OpenTurn/OpenTurn_PSoC/README.md

# OpenTurn_PSoC

OpenTurn is a closed loop servo controller for BLDCs developed for robotics application.

## Key Specificiations
| Parameter | Value |
|---|---|
|Peak Current||
|Constant Current||
|Control Frequency|20kHz|
|Supply Voltage|24V - 48V|
|Encoder Resolution|14bit|
|Communications|CAN, U(S)ART|
|Control Modes| Torque, Speed, Position|

## Hardware
### PCB
For further information check the [PCB Design Doc](http://github.com)
### Auxilary

## Software
### How to build
The firmware is developed in Modus Toolbox by Cypress. Follow this guide to build the firmware from source in Modus toolbox, or flash a [precompiled hex image](http://github.com)
