OpenTurn/OpenTurn_PSoC/software/src/OpenTurn_project/README.md

# PSoC&trade; 6 MCU: dual-CPU empty application template

This is a minimal starter dual-CPU application template for PSoC&trade; 6 MCU devices.

[View this README on GitHub.](https://github.com/Infineon/mtb-example-psoc6-dual-cpu-empty-app)

[Provide feedback on this code example.](https://cypress.co1.qualtrics.com/jfe/form/SV_1NTns53sK2yiljn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)

## Requirements

- [ModusToolbox&trade; software](https://www.cypress.com/products/modustoolbox-software-environment) v2.2 or later (tested with v2.3)
- Board support package (BSP) minimum required version: 2.0.0
- Programming language: C
- Associated parts: All [PSoC&trade; 6 MCU](https://www.cypress.com/PSoC6) parts

## Supported toolchains (make variable 'TOOLCHAIN')

- GNU Arm® embedded compiler v9.3.1 (`GCC_ARM`) - Default value of `TOOLCHAIN`
- Arm&reg; compiler v6.13 (`ARM`)
- IAR C/C++ compiler v8.42.2 (`IAR`)

## Supported kits (make variable 'TARGET')

- [PSoC&trade; 6 Wi-Fi Bluetooth® prototyping kit](https://www.cypress.com/CY8CPROTO-062-4343W) (`CY8CPROTO-062-4343W`) - Default value of `TARGET`
- [PSoC&trade; 6 Wi-Fi Bluetooth&reg; pioneer kit](https://www.cypress.com/CY8CKIT-062-WiFi-BT) (`CY8CKIT-062-WIFI-BT`)
- [PSoC&trade; 6 Bluetooth&reg; LE pioneer kit](https://www.cypress.com/CY8CKIT-062-BLE) (`CY8CKIT-062-BLE`)
- [PSoC&trade; 6 Bluetooth&reg; LE prototyping kit](https://www.cypress.com/CY8CPROTO-063-BLE) (`CY8CPROTO-063-BLE`)
- [PSoC&trade; 62S2 Wi-Fi Bluetooth&reg; pioneer kit](https://www.cypress.com/CY8CKIT-062S2-43012) (`CY8CKIT-062S2-43012`)
- [PSoC&trade; 62S1 Wi-Fi Bluetooth&reg; pioneer kit](https://www.cypress.com/CYW9P62S1-43438EVB-01) (`CYW9P62S1-43438EVB-01`)
- [PSoC&trade; 62S1 Wi-Fi Bluetooth&reg; pioneer kit](https://www.cypress.com/CYW9P62S1-43012EVB-01) (`CYW9P62S1-43012EVB-01`)
- [PSoC&trade; 62S3 Wi-Fi Bluetooth&reg; prototyping kit](https://www.cypress.com/CY8CPROTO-062S3-4343W) (`CY8CPROTO-062S3-4343W`)
- [PSoC&trade; 62S4 pioneer kit](https://www.cypress.com/CY8CKIT-062S4) (`CY8CKIT-062S4`)
- Rapid IoT connect developer kit (`CYSBSYSKIT-DEV-01`)

## Design and implementation

This template has two applications - *cm0p_app* and *cm4_app*. Their makefiles were modified to establish a dependency between the two applications, so both images built are merged into one.

In the *cm0p_app* makefile, the following line were added to specify the application CPU:

```
CORE=CM0P
```

If you intend to use the *design.modus* generated code in CM0+, add `BSP_DESIGN_MODUS` to the `COMPONENTS=` in the CM0+ Makefile.

In the *cm4_app* Makefile, the following lines were added/modified to add a dependency to *cm0p_app*:

```
DISABLE_COMPONENTS=CM0P_SLEEP
DEPENDENT_APP_PATHS=../cm0p_app

getlibs : getlibs_cm0p
getlibs_cm0p:
	$(MAKE) -C ../cm0p_app/ $(MAKECMDGOALS)
```

The last lines are added to trigger the `make getlibs` command in the *cm0p_app* folder, when issuing the same command in the *cm4_app* folder. Each application should have its own *deps* folder. If the same library is used by both applications, it should be in the *deps* folder of both applications. If the library location is specified as the shared asset repo in the *mtb* file (which is by default), they will both automatically access it from the shared location.

When the CM4 project is built, it builds both the CM0+ and CM4 applications and the resulting build artifacts contain code for both applications. When the CM0+ application is built, it will only build that application. When the application starts, the CM0+ starts first. It is responsible for starting the CM4.

By default, *cm0p_app* uses only 8192 bytes of SRAM and flash. If you wish to allocate more memory to *cm0p_app*, follow the instructions from the "Customizing linker scripts" section in [AN215656](https://www.cypress.com/AN215656) – *PSoC&trade; 6 MCU dual-CPU system design*.

The HAL library supports only the CM4 CPU, so *cyhal.h* is not included in the CM0+ application. The PDL supports both the CM4 and CM0+.

## Related resources

| Application notes | |
| :--- | :--- |
| [AN228571](https://www.cypress.com/AN228571) – Getting started with PSoC&trade; 6 MCU on ModusToolbox&trade; software | Describes PSoC&trade; 6 MCU devices and how to build your first application with ModusToolbox&trade; software |
| [AN215656](https://www.cypress.com/AN215656) – PSoC&trade; 6 MCU: dual-CPU system design | Describes the dual-CPU architecture in PSoC&trade; 6 MCU, and shows how to build a simple dual-CPU design |
| **Code examples** | |
| PSoC&trade; 6 MCU examples | [mtb-example-psoc6-*](https://github.com/cypresssemiconductorco?q=mtb-example-psoc6%20NOT%20Deprecated) on GitHub  |
| **Device documentation** | |
| [PSoC&trade; 6 MCU datasheets](https://www.cypress.com/search/all?f[0]=meta_type%3Atechnical_documents&f[1]=resource_meta_type%3A575&f[2]=field_related_products%3A114026) | [PSoC&trade; 6 technical reference manuals](https://www.cypress.com/search/all/PSoC%206%20Technical%20Reference%20Manual?f[0]=meta_type%3Atechnical_documents&f[1]=resource_meta_type%3A583) |
| **Development kits** |Visit www.cypress.com/microcontrollers-mcus-kits and use the options in the **Select your kit** section to filter kits by *Product family* or *Features*. |
| **Libraries** | |
| PSoC&trade; 6 peripheral driver library (PDL) and docs  | [mtb-pdl-cat1](https://github.com/cypresssemiconductorco/mtb-pdl-cat1) on GitHub |
| Hardware abstraction layer (HAL) Library and docs | [mtb-hal-cat1](https://github.com/cypresssemiconductorco/mtb-hal-cat1) on GitHub |
| Retarget-IO - A utility library to retarget the standard input/output (STDIO) messages to a UART port | [retarget-io](https://github.com/cypresssemiconductorco/retarget-io) on GitHub |
| **Middleware** | |
| CAPSENSE&trade; library and documents | [capsense](https://github.com/cypresssemiconductorco/capsense) on GitHub |
| Links to all PSoC&trade; 6 MCU middleware | [psoc6-middleware](https://github.com/cypresssemiconductorco/psoc6-middleware) on GitHub |
| **Tools** | |
| [Eclipse IDE for ModusToolbox&trade; software](https://www.cypress.com/modustoolbox) | ModusToolbox&trade; software is a collection of easy-to-use software and tools enabling rapid development with Infineon MCUs, covering applications from embedded sense and control to wireless and cloud-connected systems using AIROC&trade; Wi-Fi and Bluetooth® connectivity devices. |

## Other resources

Cypress provides a wealth of data at www.cypress.com to help you select the right device, and quickly and effectively integrate it into your design.

For PSoC&trade; 6 MCU devices, see [How to design with PSoC&trade; 6 MCU - KBA223067](https://community.cypress.com/docs/DOC-14644) in the Cypress community.

## Document history

Document title: *CE230479* - *PSoC&trade; 6 MCU: dual-CPU empty application template*

| Revision | Description of change |
| ---  | --- |
| 1.0.0 | New code example |
| 2.0.0 | Major update to support ModusToolbox&trade; software v2.2. <br>This version is not backward compatible with ModusToolbox&trade; software v2.1 |
| 2.1.0 | Added support for CYSBSYSKIT-DEV-01 rapid IoT connect developer kit |
| 2.2.0 | Updated to support ModusToolbox&trade; software v2.3.<br /> Added support for CY8CKIT-062S4. |
------

All other trademarks or registered trademarks referenced herein are the property of their respective owners.

banner

-------------------------------------------------------------------------------

© Cypress Semiconductor Corporation, 2019-2021. This document is the property of Cypress Semiconductor Corporation, an Infineon Technologies company, and its affiliates ("Cypress").  This document, including any software or firmware included or referenced in this document ("Software"), is owned by Cypress under the intellectual property laws and treaties of the United States and other countries worldwide.  Cypress reserves all rights under such laws and treaties and does not, except as specifically stated in this paragraph, grant any license under its patents, copyrights, trademarks, or other intellectual property rights.  If the Software is not accompanied by a license agreement and you do not otherwise have a written agreement with Cypress governing the use of the Software, then Cypress hereby grants you a personal, non-exclusive, nontransferable license (without the right to sublicense) (1) under its copyright rights in the Software (a) for Software provided in source code form, to modify and reproduce the Software solely for use with Cypress hardware products, only internally within your organization, and (b) to distribute the Software in binary code form externally to end users (either directly or indirectly through resellers and distributors), solely for use on Cypress hardware product units, and (2) under those claims of Cypress’s patents that are infringed by the Software (as provided by Cypress, unmodified) to make, use, distribute, and import the Software solely for use with Cypress hardware products.  Any other use, reproduction, modification, translation, or compilation of the Software is prohibited.
<br>
TO THE EXTENT PERMITTED BY APPLICABLE LAW, CYPRESS MAKES NO WARRANTY OF ANY KIND, EXPRESS OR IMPLIED, WITH REGARD TO THIS DOCUMENT OR ANY SOFTWARE OR ACCOMPANYING HARDWARE, INCLUDING, BUT NOT LIMITED TO, THE IMPLIED WARRANTIES OF MERCHANTABILITY AND FITNESS FOR A PARTICULAR PURPOSE.  No computing device can be absolutely secure.  Therefore, despite security measures implemented in Cypress hardware or software products, Cypress shall have no liability arising out of any security breach, such as unauthorized access to or use of a Cypress product.  CYPRESS DOES NOT REPRESENT, WARRANT, OR GUARANTEE THAT CYPRESS PRODUCTS, OR SYSTEMS CREATED USING CYPRESS PRODUCTS, WILL BE FREE FROM CORRUPTION, ATTACK, VIRUSES, INTERFERENCE, HACKING, DATA LOSS OR THEFT, OR OTHER SECURITY INTRUSION (collectively, "Security Breach").  Cypress disclaims any liability relating to any Security Breach, and you shall and hereby do release Cypress from any claim, damage, or other liability arising from any Security Breach.  In addition, the products described in these materials may contain design defects or errors known as errata which may cause the product to deviate from published specifications.  To the extent permitted by applicable law, Cypress reserves the right to make changes to this document without further notice. Cypress does not assume any liability arising out of the application or use of any product or circuit described in this document.  Any information provided in this document, including any sample design information or programming code, is provided only for reference purposes.  It is the responsibility of the user of this document to properly design, program, and test the functionality and safety of any application made of this information and any resulting product.  "High-Risk Device" means any device or system whose failure could cause personal injury, death, or property damage.  Examples of High-Risk Devices are weapons, nuclear installations, surgical implants, and other medical devices.  "Critical Component" means any component of a High-Risk Device whose failure to perform can be reasonably expected to cause, directly or indirectly, the failure of the High-Risk Device, or to affect its safety or effectiveness.  Cypress is not liable, in whole or in part, and you shall and hereby do release Cypress from any claim, damage, or other liability arising from any use of a Cypress product as a Critical Component in a High-Risk Device.  You shall indemnify and hold Cypress, including its affiliates, and its directors, officers, employees, agents, distributors, and assigns harmless from and against all claims, costs, damages, and expenses, arising out of any claim, including claims for product liability, personal injury or death, or property damage arising from any use of a Cypress product as a Critical Component in a High-Risk Device.  Cypress products are not intended or authorized for use as a Critical Component in any High-Risk Device except to the limited extent that (i) Cypress’s published data sheet for the product explicitly states Cypress has qualified the product for use in a specific High-Risk Device, or (ii) Cypress has given you advance written authorization to use the product as a Critical Component in the specific High-Risk Device and you have signed a separate indemnification agreement.
<br>
Cypress, the Cypress logo, and combinations thereof, WICED, ModusToolBox, PSoC, CapSense, EZ-USB, F-RAM, and Traveo are trademarks or registered trademarks of Cypress or a subsidiary of Cypress in the United States or in other countries.  For a more complete list of Cypress trademarks, visit cypress.com.  Other names and brands may be claimed as property of their respective owners.
