OpenTurn/OpenTurn_PSoC/hardware/3d_models/OpenTurn magnet.3mf

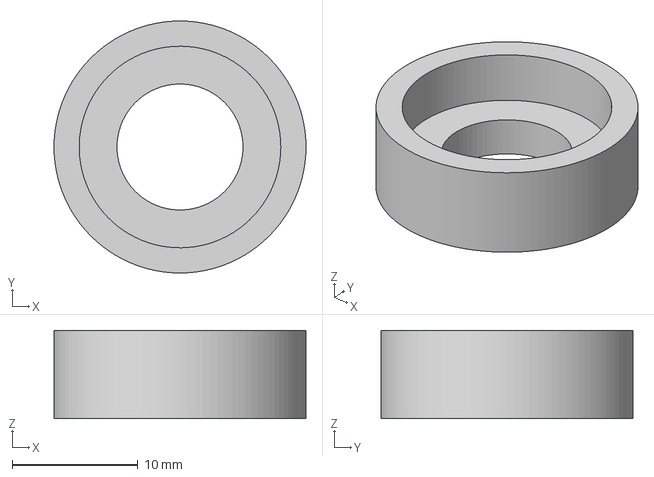
[picture p3: CAD file, 2021-10-17]
hardware/3d_models/OpenTurn magnet.3mf
20.0 x 20.0 x 7.00 mm
