OpenTurn/OpenTurn_PSoC/hardware/KiCad/doc/OpenTurn - Schematic.pdf

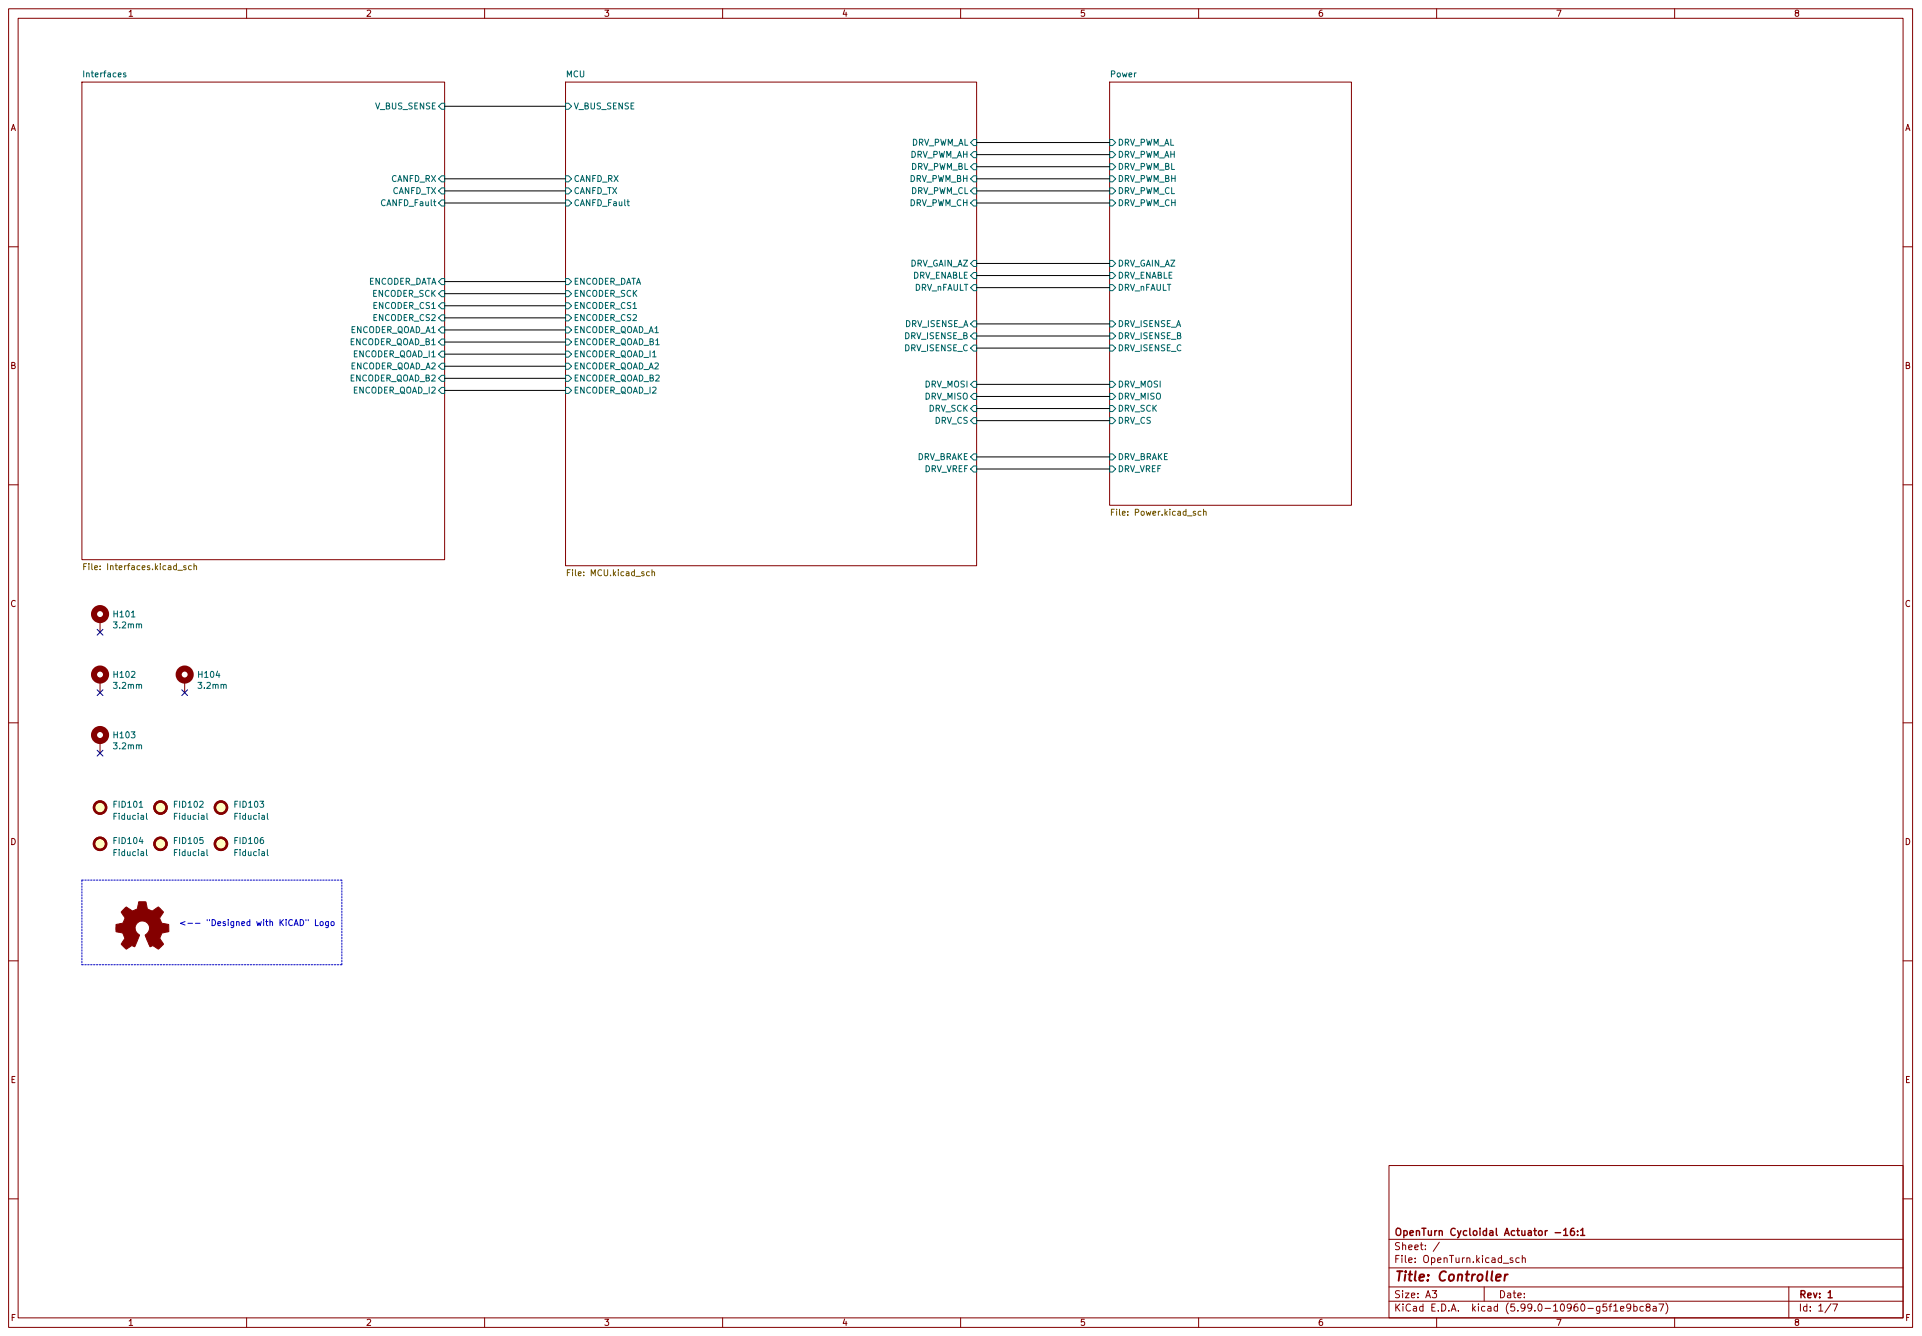
[picture p4: page 1]

<-- "Designed with KiCAD" Logo

File: OpenTurn.kicad_sch Sheet: / OpenTurn Cycloidal Actuator -16:1

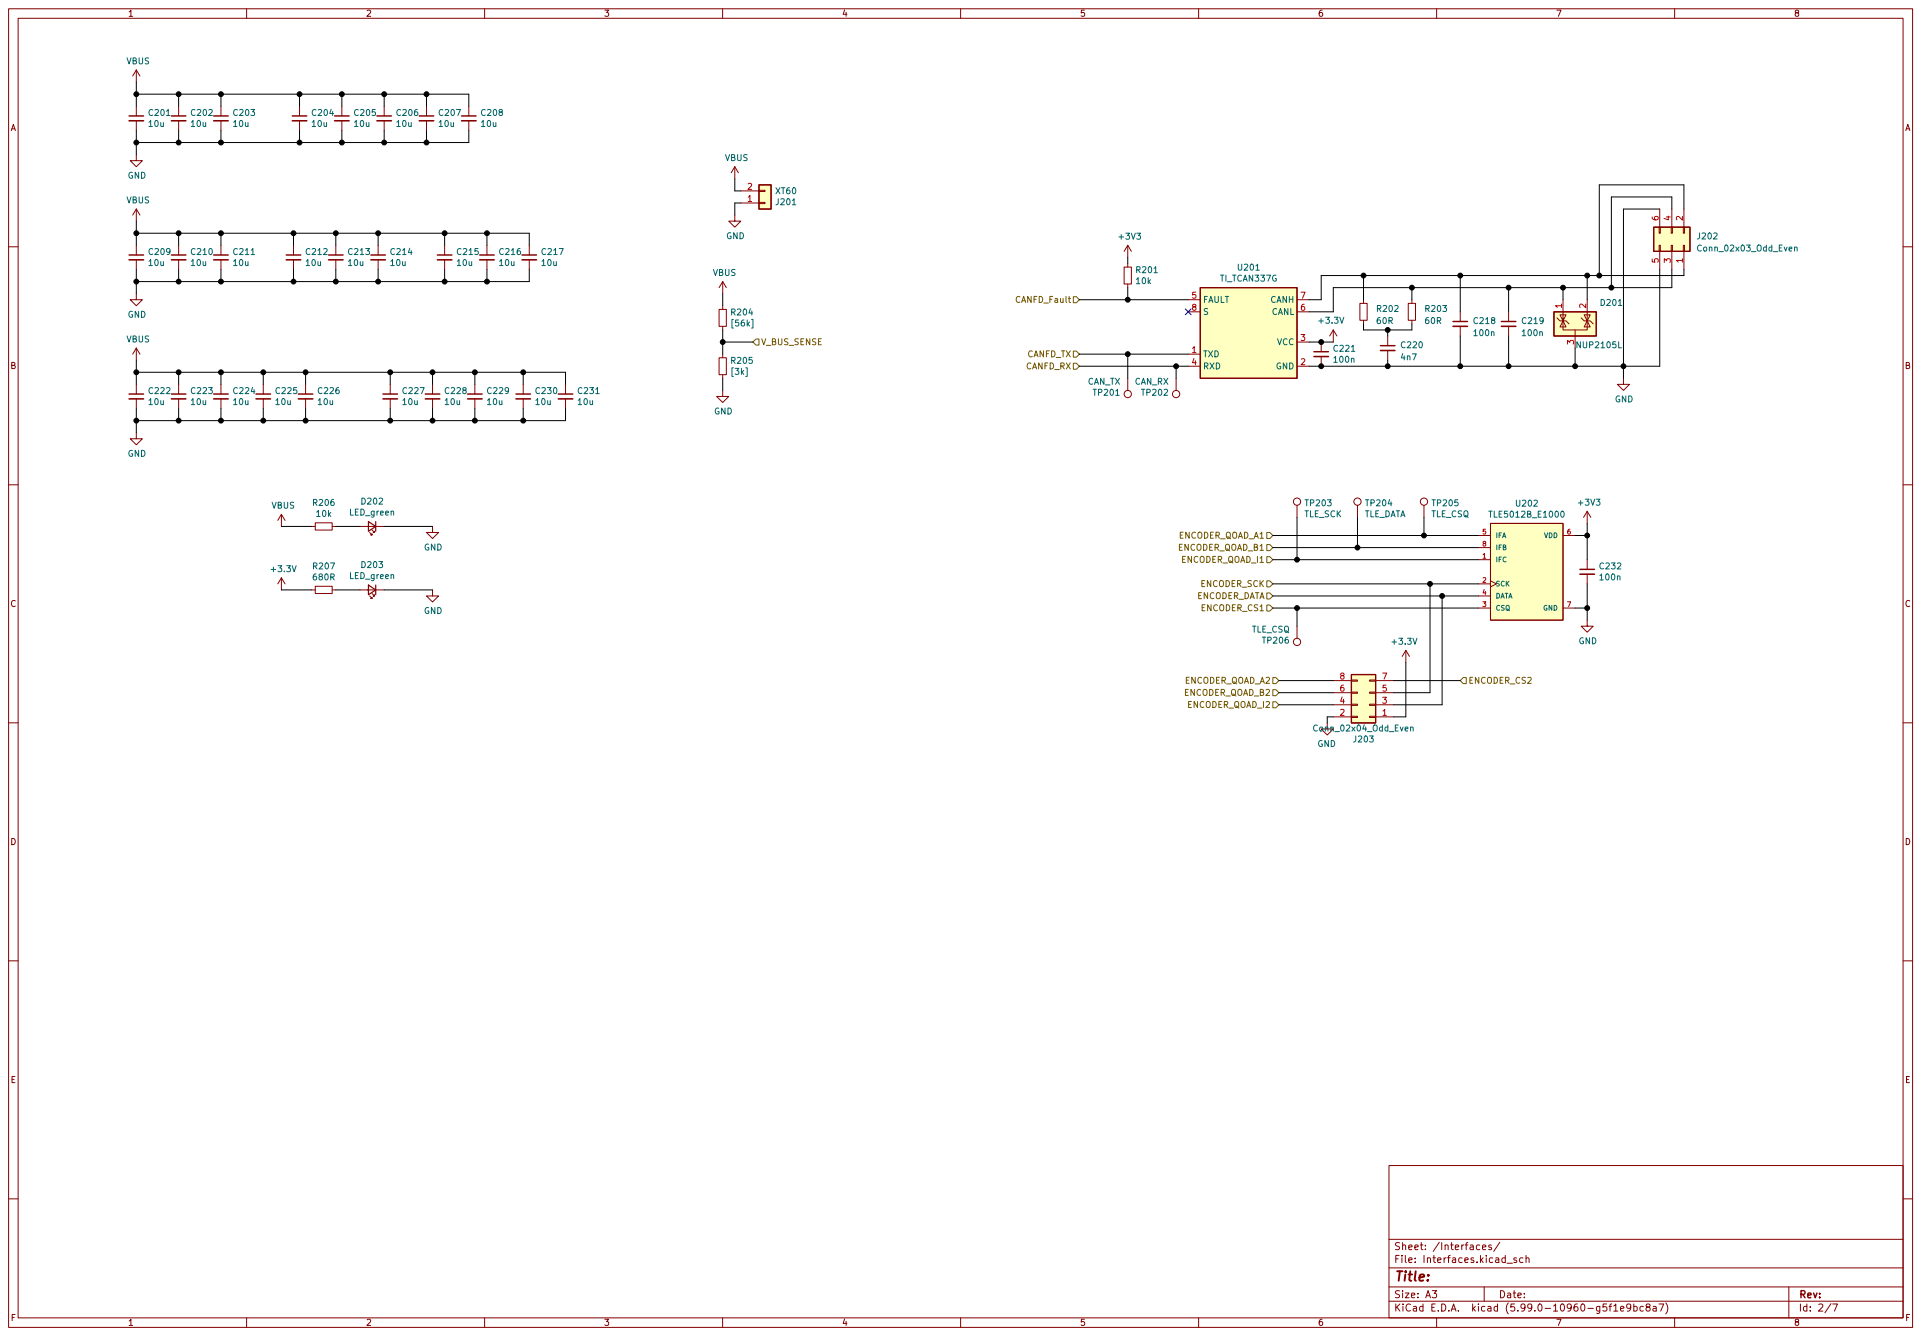
[picture p5: page 2]

File: Interfaces.kicad_sch Sheet: /Interfaces/

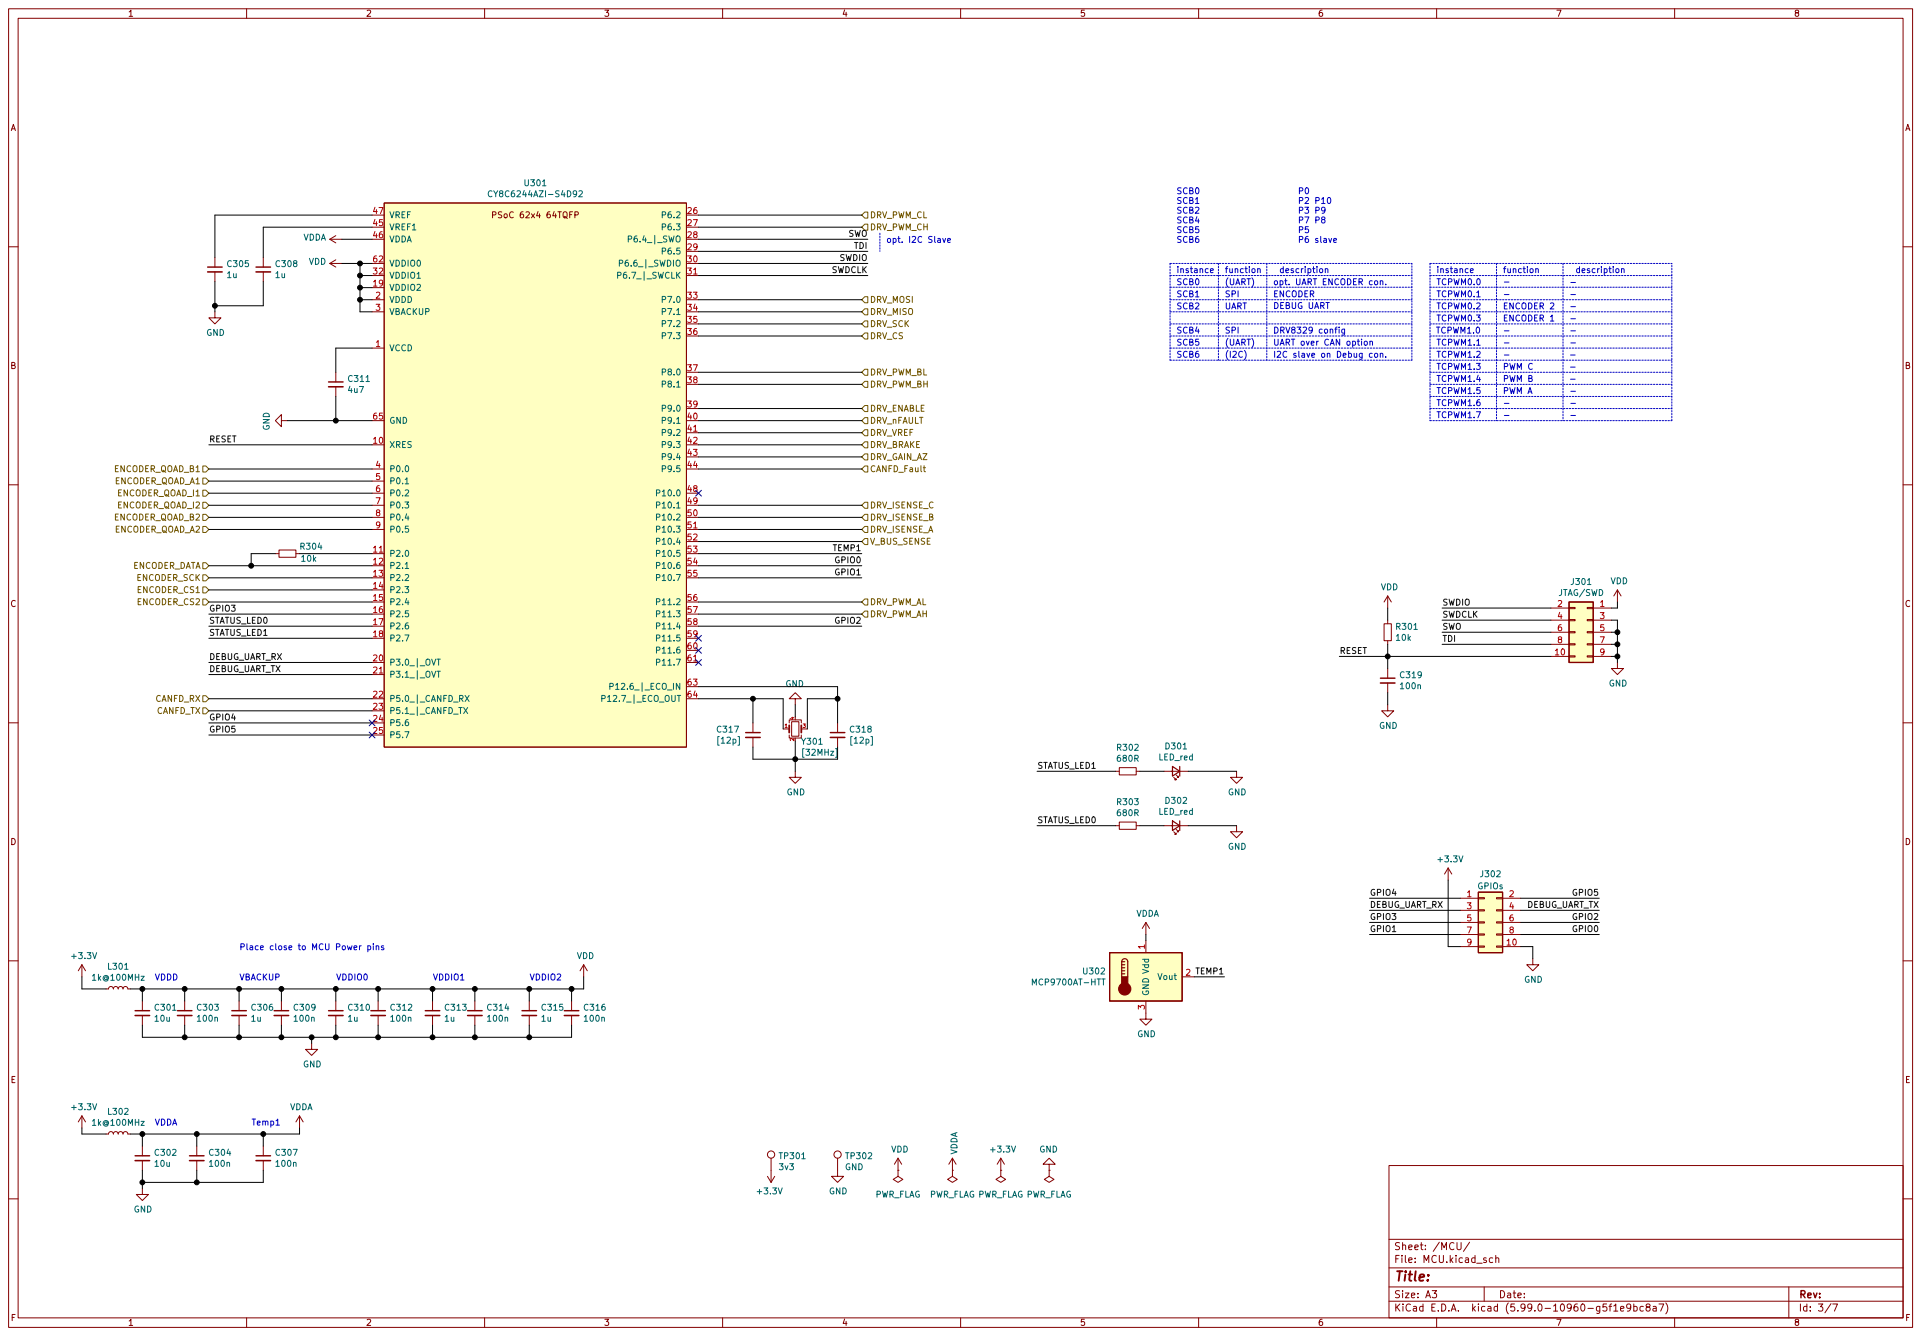
[picture p6: page 3]

-ENCODER 1 UART SPI (UART)

UART over CAN option
I2C slave on Debug con.

PWM C | -

Place close to MCU Power pins VDDIO0

File: MCU.kicad_sch Sheet: /MCU/ L302

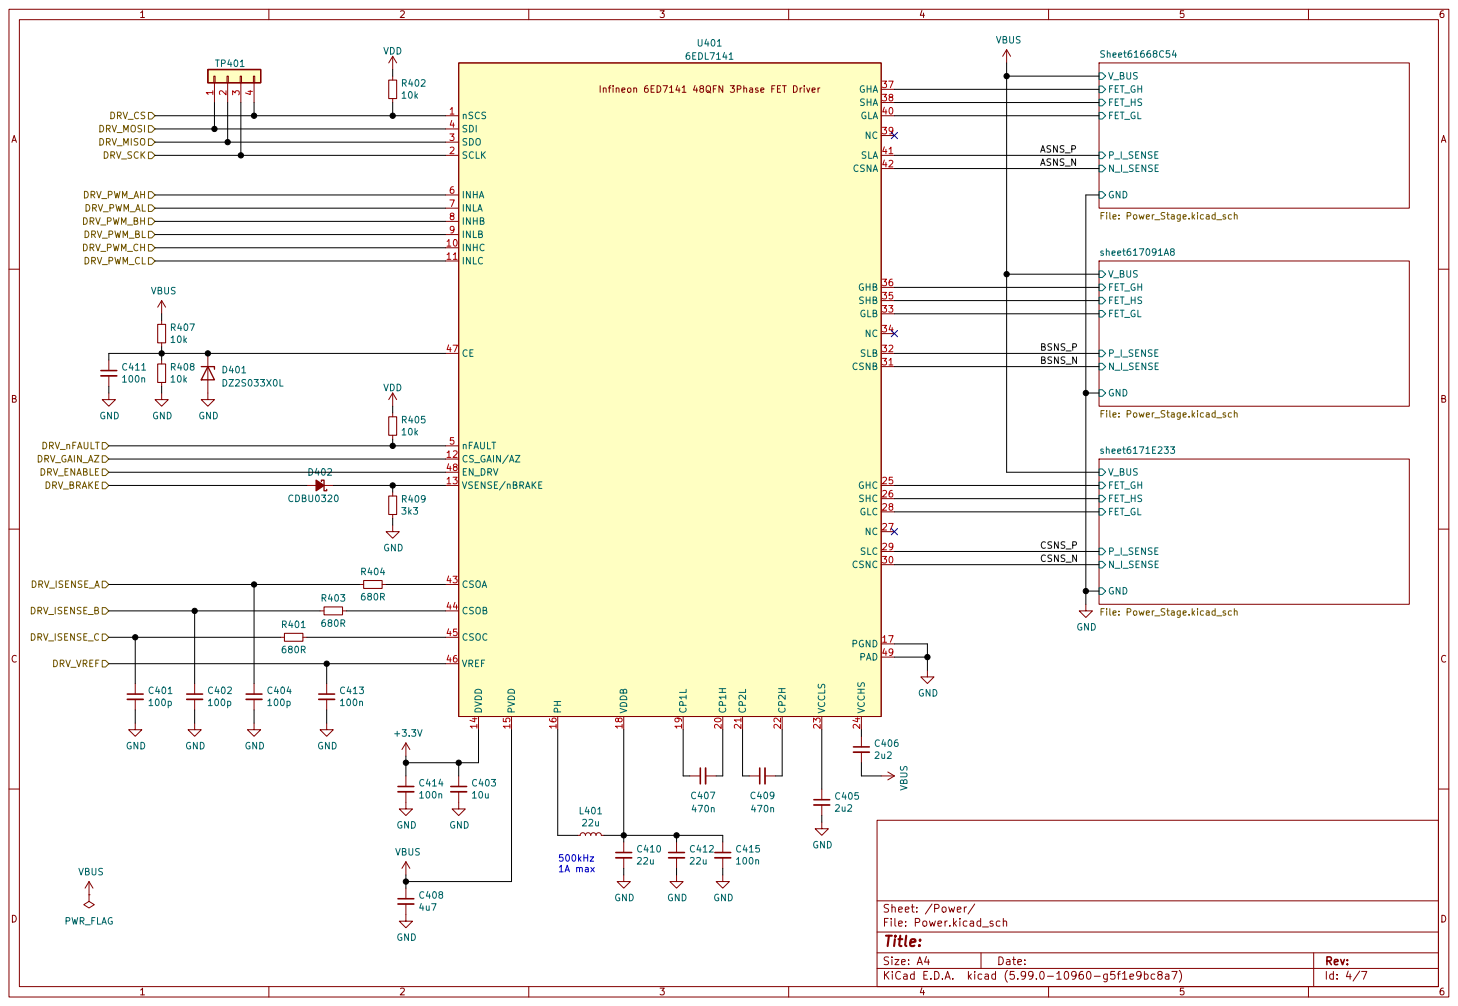
[picture p7: page 4]

Infineon 6ED7141 48QFN 3Phase FET Driver nSCS 1

ASNS_P

INHA 6 | | ASNS_N

BSNS_P

nFAULT 5 | BSNS_N

File: Power.kicad_sch Sheet: /Power/
Id: 4/7 Title:

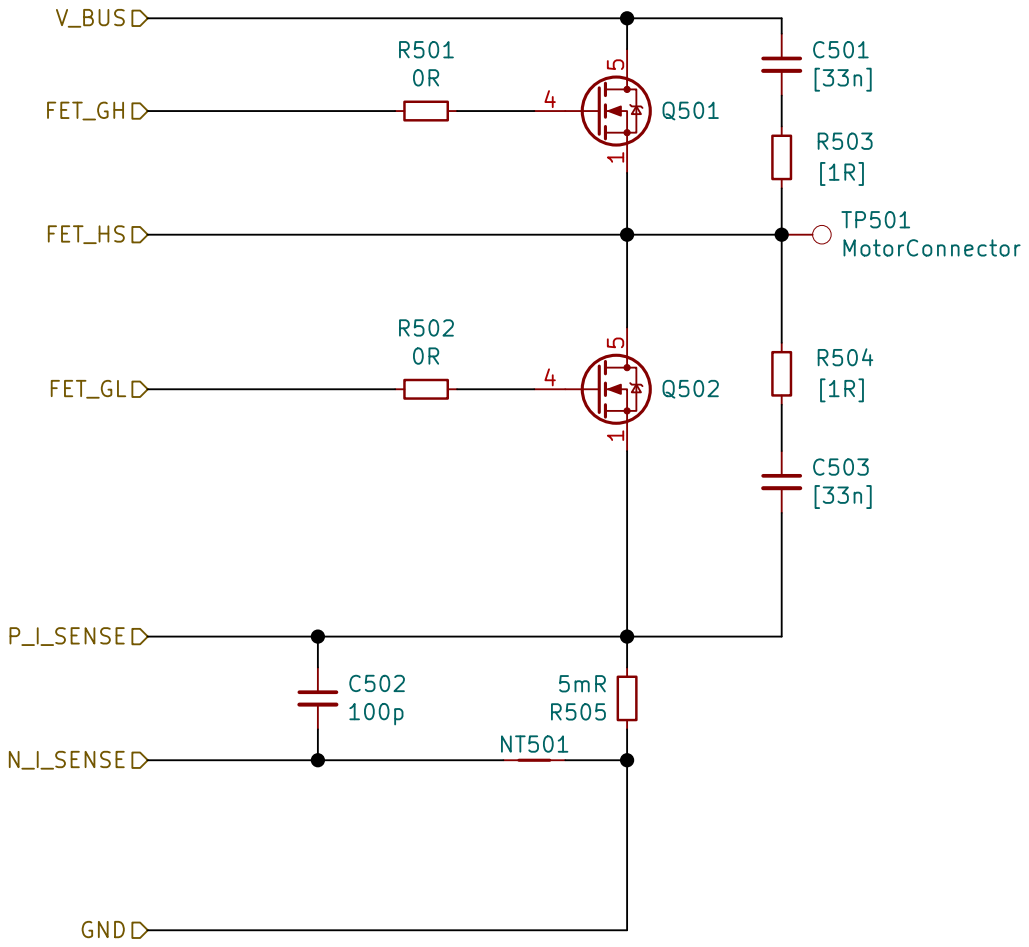
[picture p8: page 5]

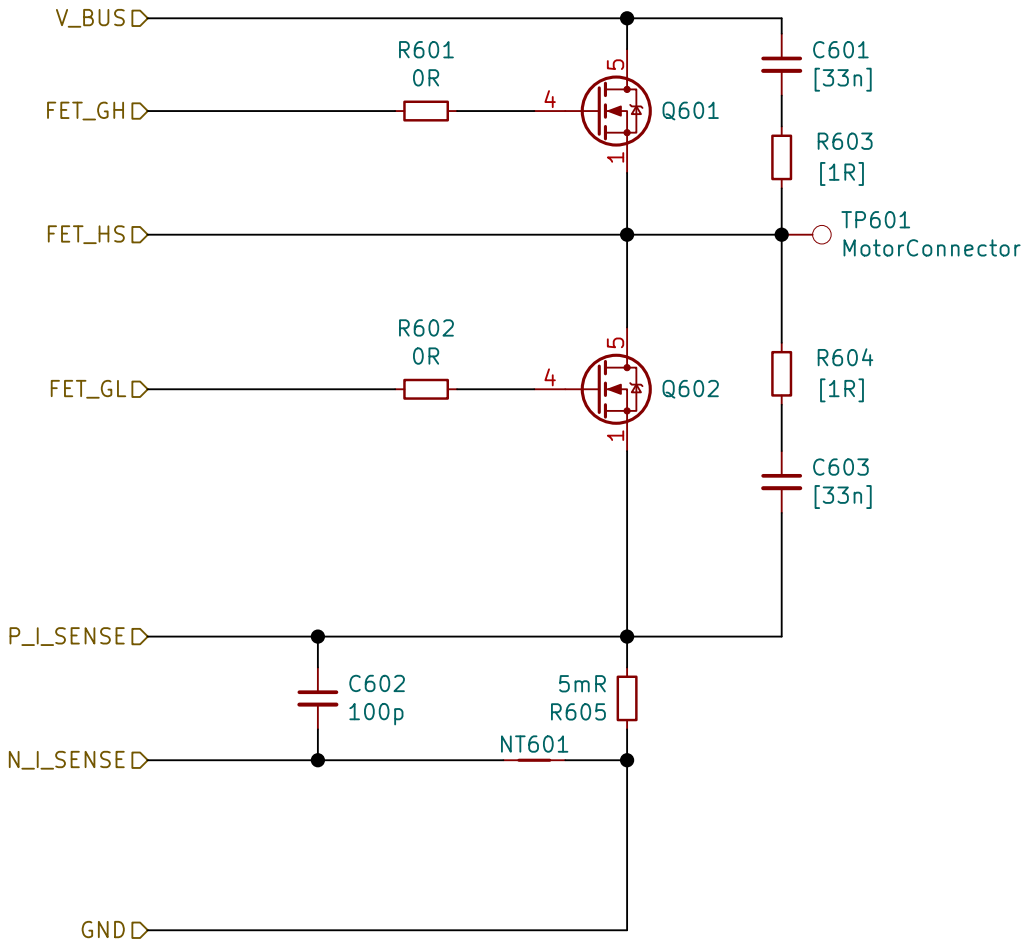
[picture p9: page 6]

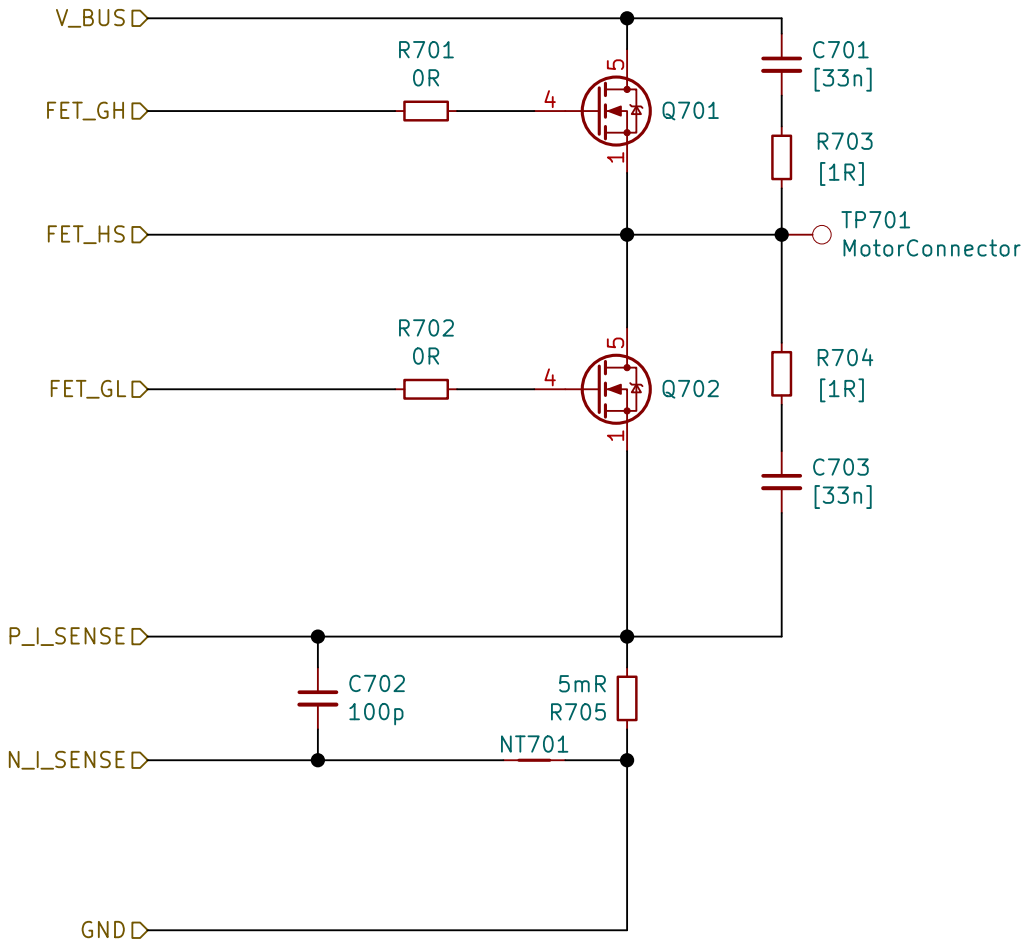
[picture p10: page 7]
