OpenTurn/OpenTurn_PSoC/software/src/OpenTurn_project/cm4_app/motor_control/float_sincos.c

/*
 * float_sincos_table.c
 *
 *  Created on: 25.02.2021
 *      Author: achim
 */

#include "float_sincos.h"





#if SINETABLE_STEPS_PER_PERIOD == 1024
const float f32_sinetable[256+1] =
{
    0.00000000000000000000f,
    0.00613588464915448000f,
    0.01227153828571990000f,
    0.01840672990580480000f,
    0.02454122852291230000f,
    0.03067480317663660000f,
    0.03680722294135880000f,
    0.04293825693494080000f,
    0.04906767432741800000f,
    0.05519524434968990000f,
    0.06132073630220860000f,
    0.06744391956366410000f,
    0.07356456359966740000f,
    0.07968243797143010000f,
    0.08579731234443990000f,
    0.09190895649713270000f,
    0.09801714032956060000f,
    0.10412163387205500000f,
    0.11022220729388300000f,
    0.11631863091190500000f,
    0.12241067519921600000f,
    0.12849811079379300000f,
    0.13458070850712600000f,
    0.14065823933284900000f,
    0.14673047445536200000f,
    0.15279718525844300000f,
    0.15885814333386100000f,
    0.16491312048997000000f,
    0.17096188876030100000f,
    0.17700422041214900000f,
    0.18303988795514100000f,
    0.18906866414980600000f,
    0.19509032201612800000f,
    0.20110463484209200000f,
    0.20711137619221900000f,
    0.21311031991609100000f,
    0.21910124015687000000f,
    0.22508391135979300000f,
    0.23105810828067100000f,
    0.23702360599436700000f,
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
};
#endif


#if SINETABLE_STEPS_PER_PERIOD == 2048
const float f32_sinetable[512+1] =
{
    0.00000000000000000000f,
    0.00306795676296598000f,
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
    0.02684143969909850000f,
    0.02760814577896570000f,
    0.02837483561767210000f,
    0.02914150876419370000f,
    0.02990816476751660000f,
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
};
#endif


void f32SinCos(uint32_t index, float *sin_val, float *cos_val)
{

  index = index & (SINETABLE_STEPS_PER_PERIOD - 1);

  if (index >= (3*SINETABLE_STEPS_PER_PERIOD/4))
  {
      *sin_val = -f32_sinetable[SINETABLE_STEPS_PER_PERIOD - index];
      *cos_val = f32_sinetable[index - (3*SINETABLE_STEPS_PER_PERIOD/4)];
  }
  else if (index >= (SINETABLE_STEPS_PER_PERIOD/2))
  {
      *sin_val = -f32_sinetable[index - (SINETABLE_STEPS_PER_PERIOD/2)];
      *cos_val = -f32_sinetable[(3*SINETABLE_STEPS_PER_PERIOD/4) - index];
  }
  else if (index >= (SINETABLE_STEPS_PER_PERIOD/4))
  {
      *sin_val = f32_sinetable[(SINETABLE_STEPS_PER_PERIOD/2) - index];
      *cos_val = -f32_sinetable[index - (SINETABLE_STEPS_PER_PERIOD/4)];
  }
  else
  {
      *sin_val = f32_sinetable[index];
      *cos_val = f32_sinetable[(SINETABLE_STEPS_PER_PERIOD/4) - index];
  }

  return;
}
