OpenTurn/OpenTurn_PSoC/software/src/OpenTurn_project/cm4_app/motor_control/led.h

/*
 * led.h
 *
 *  Created on: 23.01.2021
 *      Author: achim
 */

#ifndef MOTOR_CONTROL_LED_H_
#define MOTOR_CONTROL_LED_H_

void LED0_ON(void);
void LED0_OFF(void);
void LED0_TOGGLE(void);

void LED1_ON(void);
void LED1_OFF(void);
void LED1_TOGGLE(void);



#endif /* MOTOR_CONTROL_LED_H_ */
