OpenTurn/OpenTurn_PSoC/software/src/OpenTurn_project/cm4_app/motor_control/settings.h

/*
 * settings.h
 *
 *  Created on: 21.02.2021
 *      Author: achim
 */

#ifndef MOTOR_CONTROL_SETTINGS_H_
#define MOTOR_CONTROL_SETTINGS_H_

#include "resources.h"

void settings_LoadDefault(void);

#endif /* MOTOR_CONTROL_SETTINGS_H_ */
