OpenTurn/OpenTurn_PSoC/(commit log)

2021-10-17 initial code release
    [Interfaces.kicad_sch, MCU.kicad_sch, OpenTurn magnet.3mf, OpenTurn stand.3mf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]
2021-10-17 created subtrees for ModusToolbox
    [Interfaces.kicad_sch, MCU.kicad_sch, OpenTurn magnet.3mf, OpenTurn stand.3mf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]
